adafruit/Adafruit-INA3221-Breakout-PCB/Adafruit INA3221 Breakout.brd

## EAGLE design Adafruit INA3221 Breakout.brd (2024-10-17)

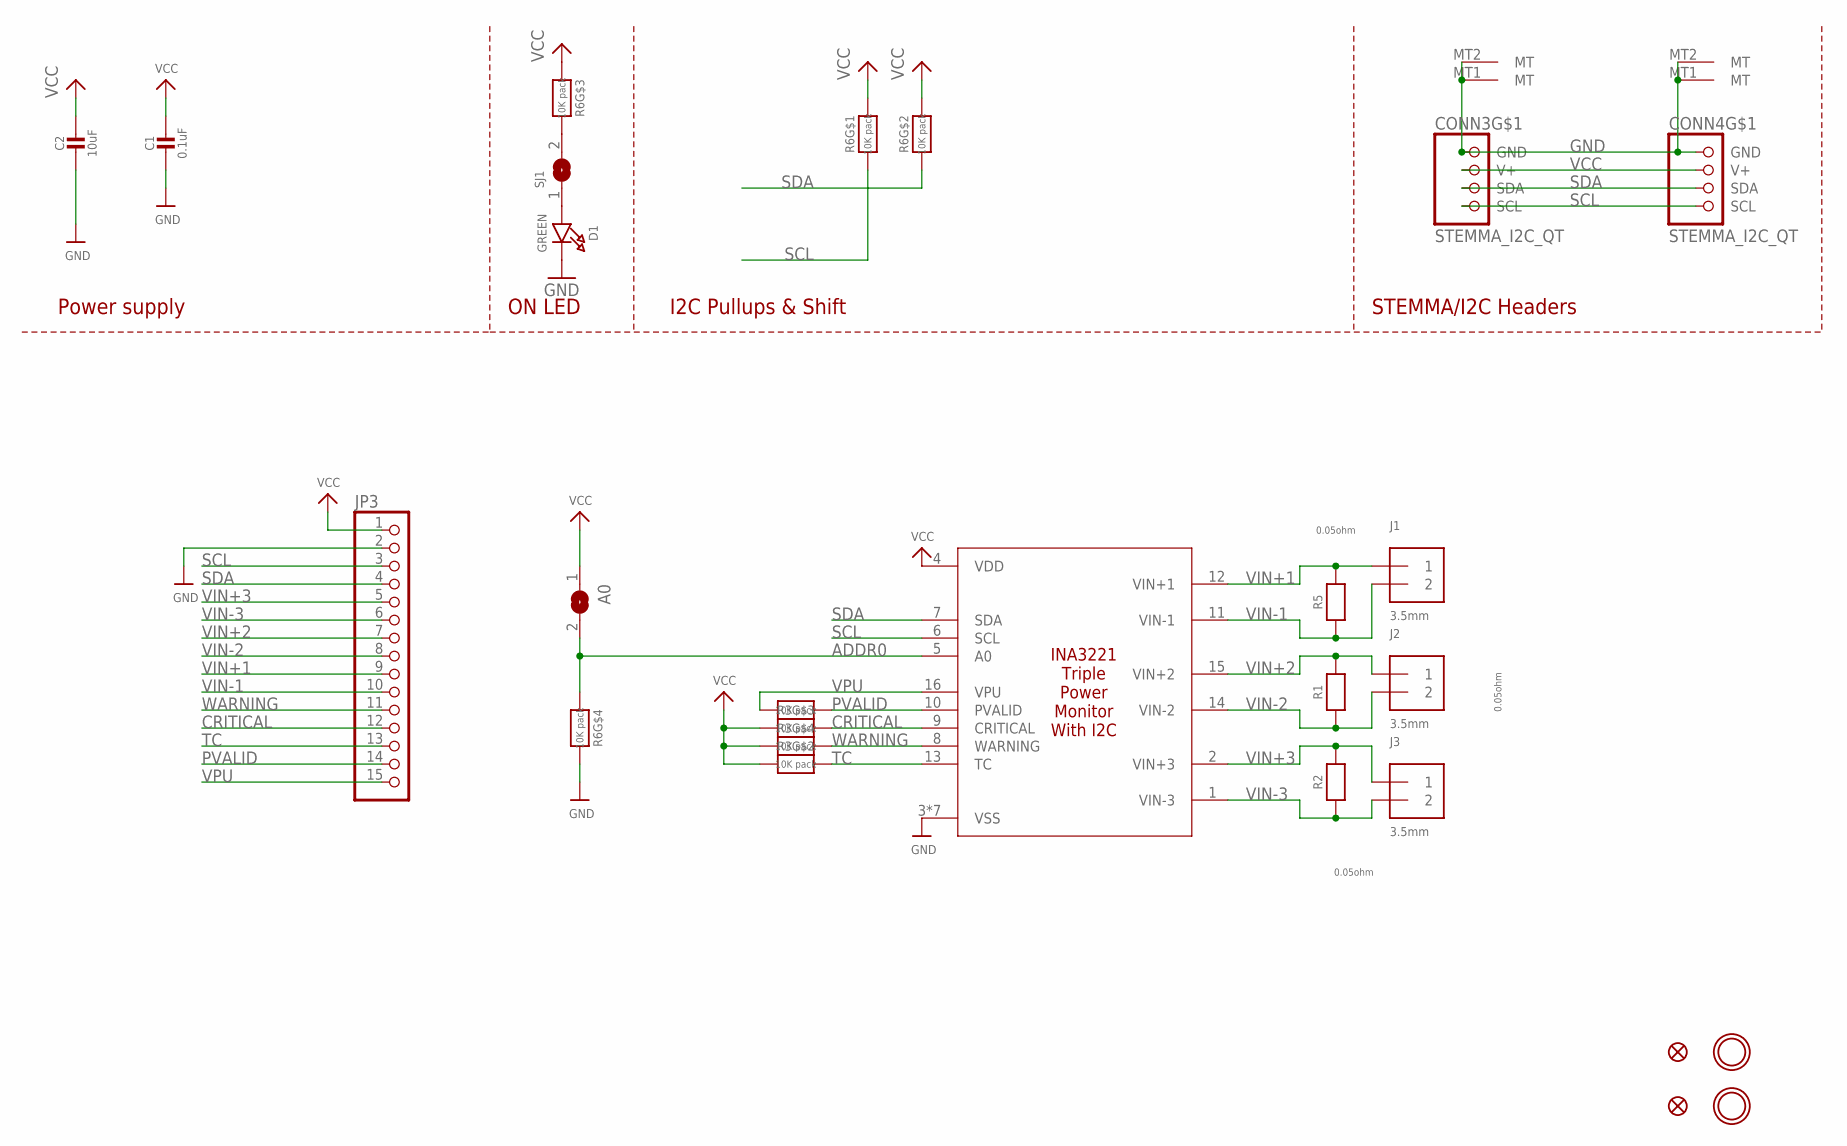
[picture p2: schematic Adafruit INA3221 Breakout.sch]

Parts:
A0: SOLDERJUMPERREFLOW_NOPASTE; SOLDERJUMPER_REFLOW_NOPASTE
C1: 0.1uF; 0603-NO
C2: 10uF; 0805-NO
CONN3, CONN4: STEMMA_I2C_QT; JST_SH4
D1: GREEN; CHIPLED_0603_NOOUTLINE
FID3, FID4: FIDUCIAL_1MM
IC1: INA3221; PVQFN-16
J1, J2, J3: 3.5mm; TERMBLOCK_1X2-3.5MM
JP3: HEADER-1X15; 1X15_ROUND_70
R1, R2, R5: 0.05ohm; _1206
R3, R6: 10K pack; RESPACK_4X0603
SJ1: SOLDERJUMPERCLOSED; SOLDERJUMPER_CLOSEDWIRE
U$20, U$21: MOUNTINGHOLE2.5; MOUNTINGHOLE_2.5_PLATED

Connections:
ADDR0: A0.2, IC1.5 (A0), R6.4 (1)
CRITICAL: IC1.9 (CRITICAL), JP3.12, R3.6 (2)
GND: C1.2, C2.2, CONN3.1 (GND), CONN3.MT1 (MT), CONN3.MT2 (MT), CONN4.1 (GND), CONN4.MT1 (MT), CONN4.MT2 (MT), D1.C, IC1.3 (VSS), IC1.P$18 (VSS), IC1.P$19 (VSS), IC1.P$20 (VSS), IC1.P$21 (VSS), IC1.P$22 (VSS), IC1.THERMAL (VSS), JP3.2, R6.5 (2)
unnamed: R6.6 (2), SJ1.2
unnamed: D1.A, SJ1.1
PVALID: IC1.10 (PVALID), JP3.14, R3.8 (2)
SCL: CONN3.4 (SCL), CONN4.4 (SCL), IC1.6 (SCL), JP3.3, R6.1
SDA: CONN3.3 (SDA), CONN4.3 (SDA), IC1.7 (SDA), JP3.4, R6.2 (1)
TC: IC1.13 (TC), JP3.13, R3.7 (2)
VCC: A0.1, C1.1, C2.1, CONN3.2 (V+), CONN4.2 (V+), IC1.4 (VDD), JP3.1, R3.2 (1), R3.3 (1), R3.4 (1), R6.3 (1), R6.7 (2), R6.8 (2)
VIN+1: IC1.12 (VIN+1), J1.1, JP3.9, R5.2
VIN+2: IC1.15 (VIN+2), J2.1, JP3.7, R1.2
VIN+3: IC1.2 (VIN+3), J3.1, JP3.5, R2.2
VIN-1: IC1.11 (VIN-1), J1.2, JP3.10, R5.1
VIN-2: IC1.14 (VIN-2), J2.2, JP3.8, R1.1
VIN-3: IC1.1 (VIN-3), J3.2, JP3.6, R2.1
VPU: IC1.16 (VPU), JP3.15, R3.1
WARNING: IC1.8 (WARNING), JP3.11, R3.5 (2)

Notes on the sheet:
I2C Pullups & Shift
STEMMA/I2C Headers
ON LED
Power supply

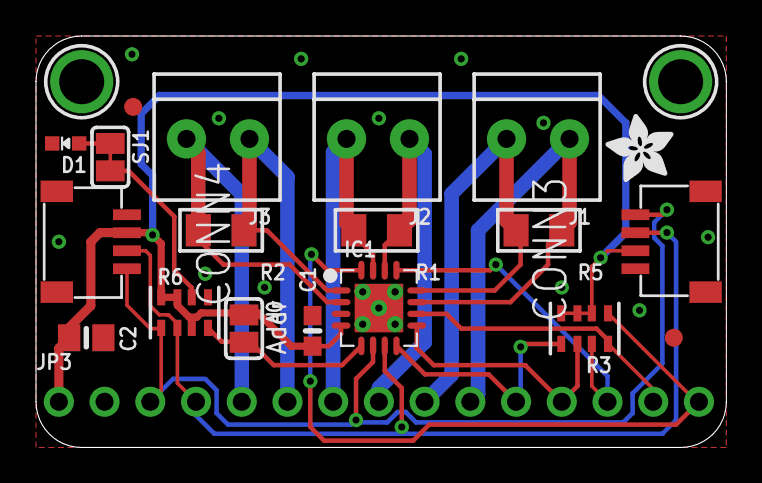
[picture p3: board Adafruit INA3221 Breakout.brd from above]

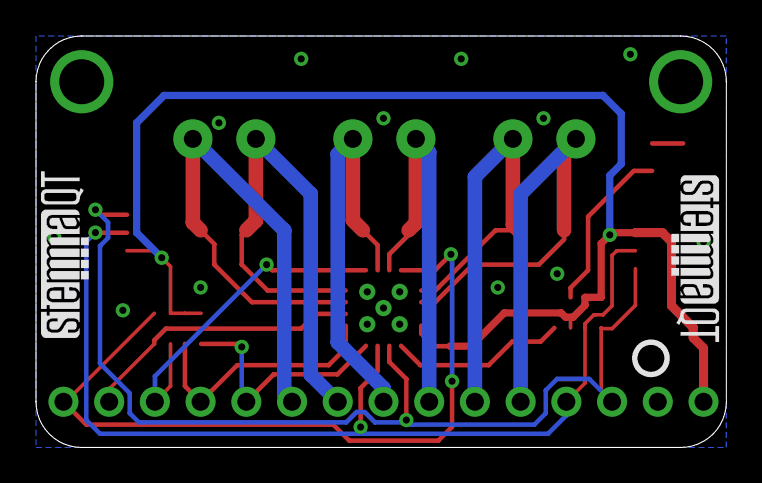
[picture p4: board Adafruit INA3221 Breakout.brd from below]

Board: 2 copper layers, 38.4 x 22.9 mm, 54 parts (7 on the bottom side), 18 nets.

Other parts of the board:
PLABEL0: PLABEL0
PLABEL1: PLABEL1
PLABEL2: PLABEL2
PLABEL3: PLABEL3
PLABEL4: PLABEL4
PLABEL5: PLABEL5
PLABEL6: PLABEL6
PLABEL7: PLABEL7
PLABEL8: PLABEL8
PLABEL9: PLABEL9
PLABEL10: PLABEL10
PLABEL11: PLABEL11
PLABEL12: PLABEL12
PLABEL13: PLABEL13
PLABEL14: PLABEL14
PLABEL15: PLABEL15
PLABEL16: PLABEL16
PLABEL17: PLABEL17
PLABEL18: PLABEL18
PLABEL19: PLABEL19
PLABEL20: PLABEL20
PLABEL21: PLABEL21
PLABEL22: PLABEL22
PLABEL23: PLABEL23
PLABEL24: PLABEL24
PLABEL25: PLABEL25
PLABEL26: PLABEL26
PLABEL27: PLABEL27
PLABEL28: PLABEL28
U$7: ADAFRUIT_3.5MM
U$30: PCBFEAT-REV-040
U$31, U$32: STEMMAQT
